cepdnaclk/e20-4yp-onchip-offline-neuromorphic-computing/soc-config/README.md

# SoC Configuration Files

This folder contains your **custom** SoC build scripts and platform configurations. These files are **tracked by git**.

## What goes here

- Custom SoC builder scripts (e.g., `build_snn_soc.py`)
- Custom platform/board definitions
- Memory map configurations
- Custom CPU wrapper configurations for integrating your RISC-V core with LiteX
