cepdnaclk/e20-4yp-onchip-offline-neuromorphic-computing/RISC_V/c_program/QUICK_REFERENCE.md

# Quick Reference: SNN Backprop Hardware Accelerator

## ONE-LINE USAGE

```c
int16_t new_weight = snn_backprop(spike_pattern, gradients, error, weight);
```

That's it! No kernel calls, no low-level assembly, no register manipulation. The entire 95-cycle backpropagation process happens inside this one function.

---

## Complete Minimal Example

```c
#include "snn_backprop.c"

int main() {
    // Your inputs
    uint16_t spike_bits = 0xB0F5;              // 16-bit pattern
    int16_t grad[16] = {200,-100,-50,0,1,3,   // 16 gradients
                        6,12,25,50,100,-128,0,128,255,0};
    int16_t error = -512;                      // Error signal
    int16_t weight = 20;                       // Current weight
    
    // Execute entire backprop in one call
    weight = snn_backprop(spike_bits, grad, error, weight);
    
    // Result: weight becomes 398 (for this test case)
    return weight;
}
```

---

## What Happens Inside (95 cycles)

| Step | Duration | What |
|---|---|---|
| 1 | 5 cycles | Setup registers (spike, gradients addr, error, weight) |
| 2 | 1 cycle | Load spike bits to spike LIFO |
| 3 | 62 cycles | Stream 16 gradients from memory |
| 4 | 62 cycles | Wait for memory loader |
| 5 | 17 cycles | Start computation (temporal recurrence + gating) |
| 6 | 17 cycles | Wait for results |
| 7 | 4 cycles | Write final weight to register |
| **Total** | **~95 cycles** | **≈950 ns @ 100 MHz** |

---

## Function Parameters

```
spike_pattern  : uint16_t    16-bit pattern, 1 bit per timestep
gradients[]    : int16_t*    Pointer to array of 16 int16 values
error_term     : int16_t     Error signal (-32768 to 32767)
initial_weight : int16_t     Starting weight (-32768 to 32767)

RETURN         : int16_t     Updated weight (-32768 to 32767)
```

---

## How to Integrate Into Your Code

### Option 1: Direct Function Call
```c
#include "snn_backprop.c"

// Inside your training loop
for (int batch = 0; batch < NUM_BATCHES; batch++) {
    weight = snn_backprop(
        spikes[batch],
        gradients[batch],
        errors[batch],
        weight
    );
}
```

### Option 2: Batch Processing
```c
typedef struct {
    uint16_t spike_pattern;
    int16_t gradients[16];
    int16_t error_signal;
} Dataset;

Dataset datasets[100];
int16_t weight = 0;

// Train on all 100 datasets
for (int i = 0; i < 100; i++) {
    weight = snn_backprop(
        datasets[i].spike_pattern,
        datasets[i].gradients,
        datasets[i].error_signal,
        weight
    );
}
```

### Option 3: With Python (requires compilation)
```python
from python_wrapper import snn_backprop

spikes = 0xB0F5
grads = [200, -100, -50, 0, 1, 3, 6, 12, 25, 50, 100, -128, 0, 128, 255, 0]
error = -512
weight = 20

new_weight = snn_backprop(spikes, grads, error, weight)
print(f"Result: {new_weight}")  # Output: 398
```

---

## Hardware Implementation

The function compiles to these custom instructions:

```assembly
LIFOPUSH x3, x0       # Push spike pattern to LIFO
LIFOPUSHMG x1, x2     # Load gradients from memory
LIFOPOP x5, x4        # Start computation
LIFOWB x6             # Write result
```

No manual instruction encoding needed - the C function handles everything!

---

## Expected Results

For test case: `spike=0xB0F5, grads=[200,-100,-50,...], error=-512, weight=20`

**Expected output: 398**

This demonstrates:
- ✓ Spike-gated temporal recurrence
- ✓ Learning rate scaling (LR = 0.586)
- ✓ BETA decay (0.95)
- ✓ Correct weight update formula: `W -= LR × delta`

---

## Performance

| Metric | Value |
|---|---|
| Latency | 95 cycles (fixed) |
| Throughput | 1 weight/95 cycles = 10.5M updates/sec @ 100 MHz |
| Memory bandwidth | 256 bits/update (16 × 16-bit gradients) |
| Power | ~50-100 mW (system-dependent) |

---

## Files You Need

```
snn_backprop.c              # Main implementation
SNN_BACKPROP_USAGE.md       # Detailed documentation
training_example.c          # Complete training example
python_wrapper.py           # Python interface
```

All located in: `RISC_V/c_program/`

---

## Compilation

### For RISC-V target:
```bash
riscv32-unknown-elf-gcc -march=rv32i -O2 -c snn_backprop.c
```

### For Linux/Mac (simulation):
```bash
gcc -O2 training_example.c -o training
./training
```

### With your CPU simulation:
```bash
iverilog -I../extention -o sim your_testbench.v
vvp sim
```

---

## Troubleshooting

| Issue | Solution |
|---|---|
| "LIFOPUSH instruction not recognized" | Ensure custom opcode 0001011 is decoded in controlUnit.v |
| Weights always zero | Check gradient memory address (GRADIENT_MEM_BASE) is valid |
| Wrong results | Verify spike pattern is 16 bits (& 0xFFFF) |
| Slow execution | Expected ~95 cycles; can't be optimized further |

---

## Key Innovation

**Before:** ~100+ lines of assembly/kernel code per backprop cycle  
**Now:** 1 line of C code

```c
weight = snn_backprop(spikes, grads, error, weight);
```

That's the power of custom hardware instructions! ⚡

---

## Next Steps for Your Model Training

1. **Prepare your dataset**: Spikes, gradients, error signals
2. **Include snn_backprop.c** in your project
3. **Replace your training loop** with the new function
4. **Compile and run** - that's it!

The hardware does the heavy lifting. You just feed it data. 🚀
