cepdnaclk/e20-4yp-onchip-offline-neuromorphic-computing/inference_accelarator/neuron_accelerator/test_labels.txt

7
2
1
0
4
1
4
9
5
9
0
6
9
0
1
5
9
7
3
4
9
6
6
5
4
0
7
4
0
1
3
1
3
4
7
2
7
1
2
1
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
