cepdnaclk/e20-4yp-onchip-offline-neuromorphic-computing/models/iris_lif_model/test_labels.txt

2
1
0
2
0
2
0
1
1
1
2
1
1
1
1
0
1
1
0
0
2
1
0
0
2
0
0
1
1
0
