cepdnaclk/e20-4yp-onchip-offline-neuromorphic-computing/models/smnist_lif_model/experiments/experiment_summary.txt

================================================================
SPIKING NEURAL NETWORK EXPERIMENT SUMMARY
================================================================
Generated on: Sun Oct 19 03:53:38 PM UTC 2025
Total configurations tested: 72
Inference time steps tested per model: 4

CONFIGURATION PARAMETERS:
----------------------------------------------------------------
Network Architecture:
  - Hidden layers: 1 2 3
  - Hidden neurons: 16 32 64 128 256 512
  - Training time steps: 25 50 75 100
  - Inference time steps: 25 50 75 100

Training Hyperparameters:
  - Epochs: 10
  - Batch size: 64
  - Learning rate: 5e-4
  - Beta (decay): 

Data Conversion:
  - Test samples: 960
  - Encoding time steps: 
  - Full dataset: false

Hardware Encoding:
  - Cluster size: 32
  - Base cluster ID: 32
  - No-spike marker: FFF

TOP PERFORMING MODELS:
----------------------------------------------------------------
By Training Accuracy:
  h512_l2_t25: 97.91% (Layers:2, Neurons:512, TrainSteps:25)
  h512_l2_t25: 97.91% (Layers:2, Neurons:512, TrainSteps:25)
  h512_l2_t25: 97.91% (Layers:2, Neurons:512, TrainSteps:25)
  h512_l2_t25: 97.91% (Layers:2, Neurons:512, TrainSteps:25)
  h512_l3_t50: 97.86% (Layers:3, Neurons:512, TrainSteps:50)

By Test Accuracy (Inference):
  h512_l2_t25 (inf_t75): 98.00% (Layers:2, Neurons:512)
  h512_l2_t25 (inf_t25): 97.92% (Layers:2, Neurons:512)
  h512_l2_t50 (inf_t75): 97.90% (Layers:2, Neurons:512)
  h512_l2_t25 (inf_t100): 97.90% (Layers:2, Neurons:512)
  h512_l2_t50 (inf_t25): 97.89% (Layers:2, Neurons:512)

================================================================
DETAILED RESULTS BY CONFIGURATION:
================================================================

Configuration: h16_l1_t25
  Architecture: 1 hidden layers × 16 neurons
  Training time steps: 25
  Training accuracy: 93.36%
  Inference results:
    Time steps 25: 93.19%
    Time steps 50: 93.33%
    Time steps 75: 93.20%
    Time steps 100: 93.31%

Configuration: h16_l1_t50
  Architecture: 1 hidden layers × 16 neurons
  Training time steps: 50
  Training accuracy: 93.31%
  Inference results:
    Time steps 25: 93.44%
    Time steps 50: 93.27%
    Time steps 75: 93.38%
    Time steps 100: 93.37%

Configuration: h16_l1_t75
  Architecture: 1 hidden layers × 16 neurons
  Training time steps: 75
  Training accuracy: 92.31%
  Inference results:
    Time steps 25: 92.28%
    Time steps 50: 92.09%
    Time steps 75: 92.22%
    Time steps 100: 92.31%

Configuration: h16_l1_t100
  Architecture: 1 hidden layers × 16 neurons
  Training time steps: 100
  Training accuracy: 92.53%
  Inference results:
    Time steps 25: 92.51%
    Time steps 50: 92.47%
    Time steps 75: 92.40%
    Time steps 100: 92.51%

Configuration: h32_l1_t25
  Architecture: 1 hidden layers × 32 neurons
  Training time steps: 25
  Training accuracy: 95.80%
  Inference results:
    Time steps 25: 95.58%
    Time steps 50: 95.61%
    Time steps 75: 95.74%
    Time steps 100: 95.77%

Configuration: h32_l1_t50
  Architecture: 1 hidden layers × 32 neurons
  Training time steps: 50
  Training accuracy: 95.50%
  Inference results:
    Time steps 25: 95.32%
    Time steps 50: 95.39%
    Time steps 75: 95.47%
    Time steps 100: 95.42%

Configuration: h32_l1_t75
  Architecture: 1 hidden layers × 32 neurons
  Training time steps: 75
  Training accuracy: 95.32%
  Inference results:
    Time steps 25: 95.32%
    Time steps 50: 95.40%
    Time steps 75: 95.22%
    Time steps 100: 95.27%

Configuration: h32_l1_t100
  Architecture: 1 hidden layers × 32 neurons
  Training time steps: 100
  Training accuracy: 94.18%
  Inference results:
    Time steps 25: 94.18%
    Time steps 50: 94.11%
    Time steps 75: 94.22%
    Time steps 100: 94.19%

Configuration: h64_l1_t25
  Architecture: 1 hidden layers × 64 neurons
  Training time steps: 25
  Training accuracy: 96.81%
  Inference results:
    Time steps 25: 96.76%
    Time steps 50: 96.83%
    Time steps 75: 96.70%
    Time steps 100: 96.79%

Configuration: h64_l1_t50
  Architecture: 1 hidden layers × 64 neurons
  Training time steps: 50
  Training accuracy: 96.09%
  Inference results:
    Time steps 25: 96.12%
    Time steps 50: 96.04%
    Time steps 75: 96.22%
    Time steps 100: 96.03%

Configuration: h64_l1_t75
  Architecture: 1 hidden layers × 64 neurons
  Training time steps: 75
  Training accuracy: 96.50%
  Inference results:
    Time steps 25: 96.41%
    Time steps 50: 96.64%
    Time steps 75: 96.51%
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
    Time steps 100: 97.79%

Configuration: h512_l3_t75
  Architecture: 3 hidden layers × 512 neurons
  Training time steps: 75
  Training accuracy: 97.68%
  Inference results:
    Time steps 25: 97.73%
    Time steps 50: 97.69%
    Time steps 75: 97.71%
    Time steps 100: 97.67%

Configuration: h512_l3_t100
  Architecture: 3 hidden layers × 512 neurons
  Training time steps: 100
  Training accuracy: 97.64%
  Inference results:
    Time steps 25: 97.61%
    Time steps 50: 97.63%
    Time steps 75: 97.69%
    Time steps 100: 97.58%

================================================================
OUTPUT STRUCTURE:
================================================================
/home/kanishka/fyp/neuromorphic-accelerator/models/smnist_lif_model/experiments/
├── experiment_results.csv              # CSV with all results
├── experiment_summary.txt         # This summary report
├── logs/                        # Execution logs
└── h{N}_l{L}_t{T}/             # Per-configuration directories
    ├── models/                  # Trained .pth models
    ├── mappings/                # neuron_mapping.txt files
    └── test_data/               # test_values_t{T}.txt files
