cepdnaclk/e20-4yp-onchip-offline-neuromorphic-computing/models/smnist_lif_model/experiments/experiment_results.csv

Config | Hidden_Layers | Hidden_Neurons | Train_Time_Steps | Train_Accuracy | Inference_Time_Steps | Test_Accuracy
h16_l1_t25 | 1 | 16 | 25 | 93.36 | 25 | 93.19
h16_l1_t25 | 1 | 16 | 25 | 93.36 | 50 | 93.33
h16_l1_t25 | 1 | 16 | 25 | 93.36 | 75 | 93.20
h16_l1_t25 | 1 | 16 | 25 | 93.36 | 100 | 93.31
h16_l1_t50 | 1 | 16 | 50 | 93.31 | 25 | 93.44
h16_l1_t50 | 1 | 16 | 50 | 93.31 | 50 | 93.27
h16_l1_t50 | 1 | 16 | 50 | 93.31 | 75 | 93.38
h16_l1_t50 | 1 | 16 | 50 | 93.31 | 100 | 93.37
h16_l1_t75 | 1 | 16 | 75 | 92.31 | 25 | 92.28
h16_l1_t75 | 1 | 16 | 75 | 92.31 | 50 | 92.09
h16_l1_t75 | 1 | 16 | 75 | 92.31 | 75 | 92.22
h16_l1_t75 | 1 | 16 | 75 | 92.31 | 100 | 92.31
h16_l1_t100 | 1 | 16 | 100 | 92.53 | 25 | 92.51
h16_l1_t100 | 1 | 16 | 100 | 92.53 | 50 | 92.47
h16_l1_t100 | 1 | 16 | 100 | 92.53 | 75 | 92.40
h16_l1_t100 | 1 | 16 | 100 | 92.53 | 100 | 92.51
h32_l1_t25 | 1 | 32 | 25 | 95.80 | 25 | 95.58
h32_l1_t25 | 1 | 32 | 25 | 95.80 | 50 | 95.61
h32_l1_t25 | 1 | 32 | 25 | 95.80 | 75 | 95.74
h32_l1_t25 | 1 | 32 | 25 | 95.80 | 100 | 95.77
h32_l1_t50 | 1 | 32 | 50 | 95.50 | 25 | 95.32
h32_l1_t50 | 1 | 32 | 50 | 95.50 | 50 | 95.39
h32_l1_t50 | 1 | 32 | 50 | 95.50 | 75 | 95.47
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
