cepdnaclk/e20-4yp-onchip-offline-neuromorphic-computing/inference_accelarator/neuron_accelerator/simulations/archive/accelerator_simulation_results_20251020_001101.csv

Config | Layers | Neurons | Train_TimeSteps | Inference_TimeSteps | Accuracy
h128_l1_t100 | 1 | 128 | 100 | 25 | 95.62
h128_l1_t100 | 1 | 128 | 100 | 50 | 96.15
h128_l1_t100 | 1 | 128 | 100 | 75 | 96.46
h128_l1_t100 | 1 | 128 | 100 | 100 | 96.46
h128_l1_t25 | 1 | 128 | 25 | 25 | 94.38
h128_l1_t25 | 1 | 128 | 25 | 50 | 95.21
