cepdnaclk/e20-4yp-onchip-offline-neuromorphic-computing/inference_accelarator/neuron_accelerator/simulations/archive/accelerator_simulation_results_20251027_135456.csv

# Neuromorphic Accelerator Simulation Results
# Generated: 2025-10-20 00:11:01
# User: e19129@localhost.localdomain
# Run Configuration:
# Mode: Full Simulation
# Layer Filter: 1 2
# Neuron Filter: All (16 32 64 128 256 512)
# Timestep Filter: 25 50 75 100
# Verbose Mode: Disabled
# Total Expected Simulations: 192
#
# CSV Format: Config | Layers | Neurons | Train_TimeSteps | Inference_TimeSteps | Accuracy
Config | Layers | Neurons | Train_TimeSteps | Inference_TimeSteps | Accuracy
h128_l1_t100 | 1 | 128 | 100 | 25 | 95.62
h128_l1_t100 | 1 | 128 | 100 | 50 | 96.15
h128_l1_t100 | 1 | 128 | 100 | 75 | 96.46
h128_l1_t100 | 1 | 128 | 100 | 100 | 96.46
h128_l1_t25 | 1 | 128 | 25 | 25 | 94.38
h128_l1_t25 | 1 | 128 | 25 | 50 | 95.21
h128_l1_t25 | 1 | 128 | 25 | 75 | 95.42
h128_l1_t25 | 1 | 128 | 25 | 100 | 95.31
h128_l1_t50 | 1 | 128 | 50 | 25 | 96.67
h128_l1_t50 | 1 | 128 | 50 | 50 | 95.83
h128_l1_t50 | 1 | 128 | 50 | 75 | 96.25
h128_l1_t50 | 1 | 128 | 50 | 100 | 96.46
h128_l1_t75 | 1 | 128 | 75 | 25 | 95.21
h128_l1_t75 | 1 | 128 | 75 | 50 | 95.21
h128_l1_t75 | 1 | 128 | 75 | 75 | 95.21
h128_l1_t75 | 1 | 128 | 75 | 100 | 95.62
h128_l2_t100 | 2 | 128 | 100 | 25 | 73.54
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
