cepdnaclk/e20-4yp-onchip-offline-neuromorphic-computing/surrogate_lut/surrogate_lut_wb.v

`timescale 1ns/100ps

// =============================================================================
//  surrogate_lut_wb.v — Surrogate Gradient Lookup Table (Wishbone Slave)
//  Project: On-Chip Offline Neuromorphic Computing (FYP)
// =============================================================================
//
//  Description:
//      A read-only 256-entry ROM that maps 8-bit membrane potential values
//      to their pre-calculated fast sigmoid surrogate gradient equivalents.
//
//      Used during STATE 2 (Surrogate Substitution):
//          - CPU reads V_mem from data memory
//          - CPU queries this LUT using V_mem as address index
//          - CPU writes returned surrogate gradient back to same memory location
//          - STATE 3 (Learning) then reads surrogate values directly → no
//            runtime surrogate computation needed
//
//  Surrogate Function:
//      h(v) = 1 / (1 + k * |v / 128|)^2,  k=4.0
//      Output: 8-bit unsigned fixed-point, 0xFF = 1.0 (peak at v=0)
//
//  Address Scheme (Wishbone):
//      CPU uses V_mem (8-bit unsigned) as word-offset into this peripheral.
//      To query LUT for membrane potential v_mem:
//          wb_addr = BASE_ADDR + (v_mem_unsigned * 4)
//      Note: v_mem stored in memory is treated as raw 8-bit (unsigned index).
//            Signed interpretation is embedded in the pre-calculated values.
//
//  LUT Index → Signed V_mem mapping:
//      Index   0   = v_mem =    0  (peak, grad = 1.0)
//      Index   1   = v_mem =   +1
//      ...
//      Index 127   = v_mem =  +127
//      Index 128   = v_mem =  -128
//      ...
//      Index 255   = v_mem =   -1  (near-peak, grad ≈ 0.94)
//
//  Wishbone Interface: Classic (non-pipelined), single-cycle ACK
//  Bus Width: 32-bit (surrogate value returned in bits [7:0])
//  Writes: ignored but ACK returned (peripheral is read-only)
//
//  Parameters:
//      BASE_ADDR — base address of this peripheral in the SoC address map
//                  (1 KB aligned: lower 10 bits must be zero)
// =============================================================================

module surrogate_lut_wb #(
    parameter [31:0] BASE_ADDR = 32'hA000_0000   // override in SoC integration
)(
    // ---- Wishbone Classic Slave Interface ----
    input  wire        wb_clk_i,
    input  wire        wb_rst_i,
    input  wire [31:0] wb_adr_i,   // Address from master
    input  wire [31:0] wb_dat_i,   // Data in  (ignored — read-only peripheral)
    input  wire  [3:0] wb_sel_i,   // Byte select (unused, always full word)
    input  wire        wb_we_i,    // Write enable
    input  wire        wb_stb_i,   // Strobe
    input  wire        wb_cyc_i,   // Bus cycle valid
    output reg  [31:0] wb_dat_o,   // Data out — surrogate gradient in [7:0]
    output reg         wb_ack_o    // Acknowledge
);

    // -------------------------------------------------------------------------
    //  ROM Declaration — 256 × 8-bit
    //  Synthesis tools (Vivado/Quartus) infer this as LUTRAM or Block RAM.
    //  The initial block is supported for ROM inference in synthesis.
    // -------------------------------------------------------------------------
    reg [7:0] lut_rom [0:255];

    initial begin
        // Values generated by gen_lut.py
        // h(v) = 1/(1 + 4*|v/128|)^2, scaled to uint8 (0xFF=1.0)
        // Index = raw 8-bit unsigned storage of V_mem
        lut_rom[  0] = 8'hFF;  // v =    0  grad ≈ 1.0000  ← PEAK
        lut_rom[  1] = 8'hF0;  // v =    1  grad ≈ 0.9412
        lut_rom[  2] = 8'hE2;  // v =    2  grad ≈ 0.8863
        lut_rom[  3] = 8'hD5;  // v =    3  grad ≈ 0.8353
        lut_rom[  4] = 8'hC9;  // v =    4  grad ≈ 0.7882
        lut_rom[  5] = 8'hBF;  // v =    5  grad ≈ 0.7490
        lut_rom[  6] = 8'hB5;  // v =    6  grad ≈ 0.7098
        lut_rom[  7] = 8'hAC;  // v =    7  grad ≈ 0.6745
        lut_rom[  8] = 8'hA3;  // v =    8  grad ≈ 0.6392
        lut_rom[  9] = 8'h9B;  // v =    9  grad ≈ 0.6078
        lut_rom[ 10] = 8'h94;  // v =   10  grad ≈ 0.5804
        lut_rom[ 11] = 8'h8D;  // v =   11  grad ≈ 0.5529
        lut_rom[ 12] = 8'h87;  // v =   12  grad ≈ 0.5294
        lut_rom[ 13] = 8'h81;  // v =   13  grad ≈ 0.5059
        lut_rom[ 14] = 8'h7B;  // v =   14  grad ≈ 0.4824
        lut_rom[ 15] = 8'h76;  // v =   15  grad ≈ 0.4627
        lut_rom[ 16] = 8'h71;  // v =   16  grad ≈ 0.4431
        lut_rom[ 17] = 8'h6D;  // v =   17  grad ≈ 0.4275
        lut_rom[ 18] = 8'h68;  // v =   18  grad ≈ 0.4078
        lut_rom[ 19] = 8'h64;  // v =   19  grad ≈ 0.3922
        lut_rom[ 20] = 8'h61;  // v =   20  grad ≈ 0.3804
        lut_rom[ 21] = 8'h5D;  // v =   21  grad ≈ 0.3647
        lut_rom[ 22] = 8'h5A;  // v =   22  grad ≈ 0.3529
        lut_rom[ 23] = 8'h56;  // v =   23  grad ≈ 0.3373
        lut_rom[ 24] = 8'h53;  // v =   24  grad ≈ 0.3255
        lut_rom[ 25] = 8'h50;  // v =   25  grad ≈ 0.3137
        lut_rom[ 26] = 8'h4E;  // v =   26  grad ≈ 0.3059
        lut_rom[ 27] = 8'h4B;  // v =   27  grad ≈ 0.2941
        lut_rom[ 28] = 8'h49;  // v =   28  grad ≈ 0.2863
        lut_rom[ 29] = 8'h46;  // v =   29  grad ≈ 0.2745
        lut_rom[ 30] = 8'h44;  // v =   30  grad ≈ 0.2667
        lut_rom[ 31] = 8'h42;  // v =   31  grad ≈ 0.2588
        lut_rom[ 32] = 8'h40;  // v =   32  grad ≈ 0.2510
        lut_rom[ 33] = 8'h3E;  // v =   33  grad ≈ 0.2431
        lut_rom[ 34] = 8'h3C;  // v =   34  grad ≈ 0.2353
        lut_rom[ 35] = 8'h3A;  // v =   35  grad ≈ 0.2275
        lut_rom[ 36] = 8'h38;  // v =   36  grad ≈ 0.2196
        lut_rom[ 37] = 8'h37;  // v =   37  grad ≈ 0.2157
        lut_rom[ 38] = 8'h35;  // v =   38  grad ≈ 0.2078
        lut_rom[ 39] = 8'h34;  // v =   39  grad ≈ 0.2039
        lut_rom[ 40] = 8'h32;  // v =   40  grad ≈ 0.1961
        lut_rom[ 41] = 8'h31;  // v =   41  grad ≈ 0.1922
        lut_rom[ 42] = 8'h30;  // v =   42  grad ≈ 0.1882
        lut_rom[ 43] = 8'h2E;  // v =   43  grad ≈ 0.1804
        lut_rom[ 44] = 8'h2D;  // v =   44  grad ≈ 0.1765
        lut_rom[ 45] = 8'h2C;  // v =   45  grad ≈ 0.1725
        lut_rom[ 46] = 8'h2B;  // v =   46  grad ≈ 0.1686
        lut_rom[ 47] = 8'h2A;  // v =   47  grad ≈ 0.1647
        lut_rom[ 48] = 8'h29;  // v =   48  grad ≈ 0.1608
        lut_rom[ 49] = 8'h28;  // v =   49  grad ≈ 0.1569
        lut_rom[ 50] = 8'h27;  // v =   50  grad ≈ 0.1529
        lut_rom[ 51] = 8'h26;  // v =   51  grad ≈ 0.1490
        lut_rom[ 52] = 8'h25;  // v =   52  grad ≈ 0.1451
        lut_rom[ 53] = 8'h24;  // v =   53  grad ≈ 0.1412
        lut_rom[ 54] = 8'h23;  // v =   54  grad ≈ 0.1373
        lut_rom[ 55] = 8'h22;  // v =   55  grad ≈ 0.1333
        lut_rom[ 56] = 8'h22;  // v =   56  grad ≈ 0.1333
        lut_rom[ 57] = 8'h21;  // v =   57  grad ≈ 0.1294
        lut_rom[ 58] = 8'h20;  // v =   58  grad ≈ 0.1255
        lut_rom[ 59] = 8'h20;  // v =   59  grad ≈ 0.1255
        lut_rom[ 60] = 8'h1F;  // v =   60  grad ≈ 0.1216
        lut_rom[ 61] = 8'h1E;  // v =   61  grad ≈ 0.1176
        lut_rom[ 62] = 8'h1E;  // v =   62  grad ≈ 0.1176
        lut_rom[ 63] = 8'h1D;  // v =   63  grad ≈ 0.1137
        lut_rom[ 64] = 8'h1C;  // v =   64  grad ≈ 0.1098
        lut_rom[ 65] = 8'h1C;  // v =   65  grad ≈ 0.1098
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
        lut_rom[240] = 8'h71;  // v =  -16  grad ≈ 0.4431
        lut_rom[241] = 8'h76;  // v =  -15  grad ≈ 0.4627
        lut_rom[242] = 8'h7B;  // v =  -14  grad ≈ 0.4824
        lut_rom[243] = 8'h81;  // v =  -13  grad ≈ 0.5059
        lut_rom[244] = 8'h87;  // v =  -12  grad ≈ 0.5294
        lut_rom[245] = 8'h8D;  // v =  -11  grad ≈ 0.5529
        lut_rom[246] = 8'h94;  // v =  -10  grad ≈ 0.5804
        lut_rom[247] = 8'h9B;  // v =   -9  grad ≈ 0.6078
        lut_rom[248] = 8'hA3;  // v =   -8  grad ≈ 0.6392
        lut_rom[249] = 8'hAC;  // v =   -7  grad ≈ 0.6745
        lut_rom[250] = 8'hB5;  // v =   -6  grad ≈ 0.7098
        lut_rom[251] = 8'hBF;  // v =   -5  grad ≈ 0.7490
        lut_rom[252] = 8'hC9;  // v =   -4  grad ≈ 0.7882
        lut_rom[253] = 8'hD5;  // v =   -3  grad ≈ 0.8353
        lut_rom[254] = 8'hE2;  // v =   -2  grad ≈ 0.8863
        lut_rom[255] = 8'hF0;  // v =   -1  grad ≈ 0.9412
    end

    // -------------------------------------------------------------------------
    //  Address Decode
    //  The peripheral occupies a 1 KB window (256 words × 4 bytes).
    //  Upper bits [31:10] must match BASE_ADDR[31:10] for chip select.
    //  Bits [9:2] give the 8-bit LUT index (= raw V_mem byte).
    // -------------------------------------------------------------------------
    wire        cs      = wb_cyc_i & wb_stb_i &
                          (wb_adr_i[31:10] == BASE_ADDR[31:10]);
    wire [7:0]  lut_idx = wb_adr_i[9:2];   // word-aligned → strip lower 2 bits

    // -------------------------------------------------------------------------
    //  Wishbone Response — single clock cycle
    // -------------------------------------------------------------------------
    always @(posedge wb_clk_i) begin
        // Default: deassert ACK
        wb_ack_o <= 1'b0;
        wb_dat_o <= 32'h0000_0000;

        if (wb_rst_i) begin
            wb_ack_o <= 1'b0;
            wb_dat_o <= 32'h0000_0000;
        end
        else if (cs) begin
            if (!wb_we_i) begin
                // READ: return surrogate gradient in lower byte
                wb_dat_o <= {24'h000000, lut_rom[lut_idx]};
            end
            // WRITE: ignore dat_i, peripheral is read-only
            // ACK either way so master doesn't hang
            wb_ack_o <= 1'b1;
        end
    end

endmodule
