cepdnaclk/e20-4yp-onchip-offline-neuromorphic-computing/(commit log)

2026-01-01 Add spike forwarder controllers, weight resolver modules, and tools for weight export and spike input generation
    [accelerator_simulation_results.csv, accelerator_simulation_results_20251020_001101.csv, accelerator_simulation_results_20251027_135456.csv]
2026-01-22 RISC-V CPU architecture with multiple pipeline stages, hazard handling, and extensive test infrastructure.
2026-02-14 refactor: Relocate RTL and simulation files to the new inference_accelarator project structure.
    [accelerator_simulation_results.csv, accelerator_simulation_results_20251020_001101.csv, accelerator_simulation_results_20251027_135456.csv]
2026-03-05 fix dump mechanism in neuron accelarator and create comprehensive testbench to debug
    [neuron.v, neuron_accelerator.v, neuron_cluster.v, neuron_cluster_tb.v, neuron_cluster_vmem_tb.v, neuron_layer.v, potential_adder.v, spike_forwarder_4_tb.v]
2026-03-06 Add RTL test suite documentation and update run_tests.sh script
    - Created TESTING.md to provide detailed instructions for running the SNN Accelerator RTL test suite, including prerequisites, test levels, and expected outputs.
    - Implemented a new run_tests.sh script to streamline the execution of all test levels (L2a to L7) with improved output formatting and error handling.
    - Enhanced the test execution process with filtering options to run specific test levels.
2026-03-13 first inference
    [experiment_results.csv, sample_0_unified.csv, smem_all_samples.csv]
2026-03-13 last value
    [inference_blame.csv, inference_errors.csv, smem_backprop_surrogate_single.csv]
2026-03-13 added various C programs, Python analysis tools, and reports for hardware/software verification and weight analysis.
    [ablation_accuracy_matrix.csv, replay32_diff_report.txt, replay32_spikeapprox_diff_report.txt]
